leesanghyoek/Quiz-Clicker_IoT-Device/docs/images/erd.png

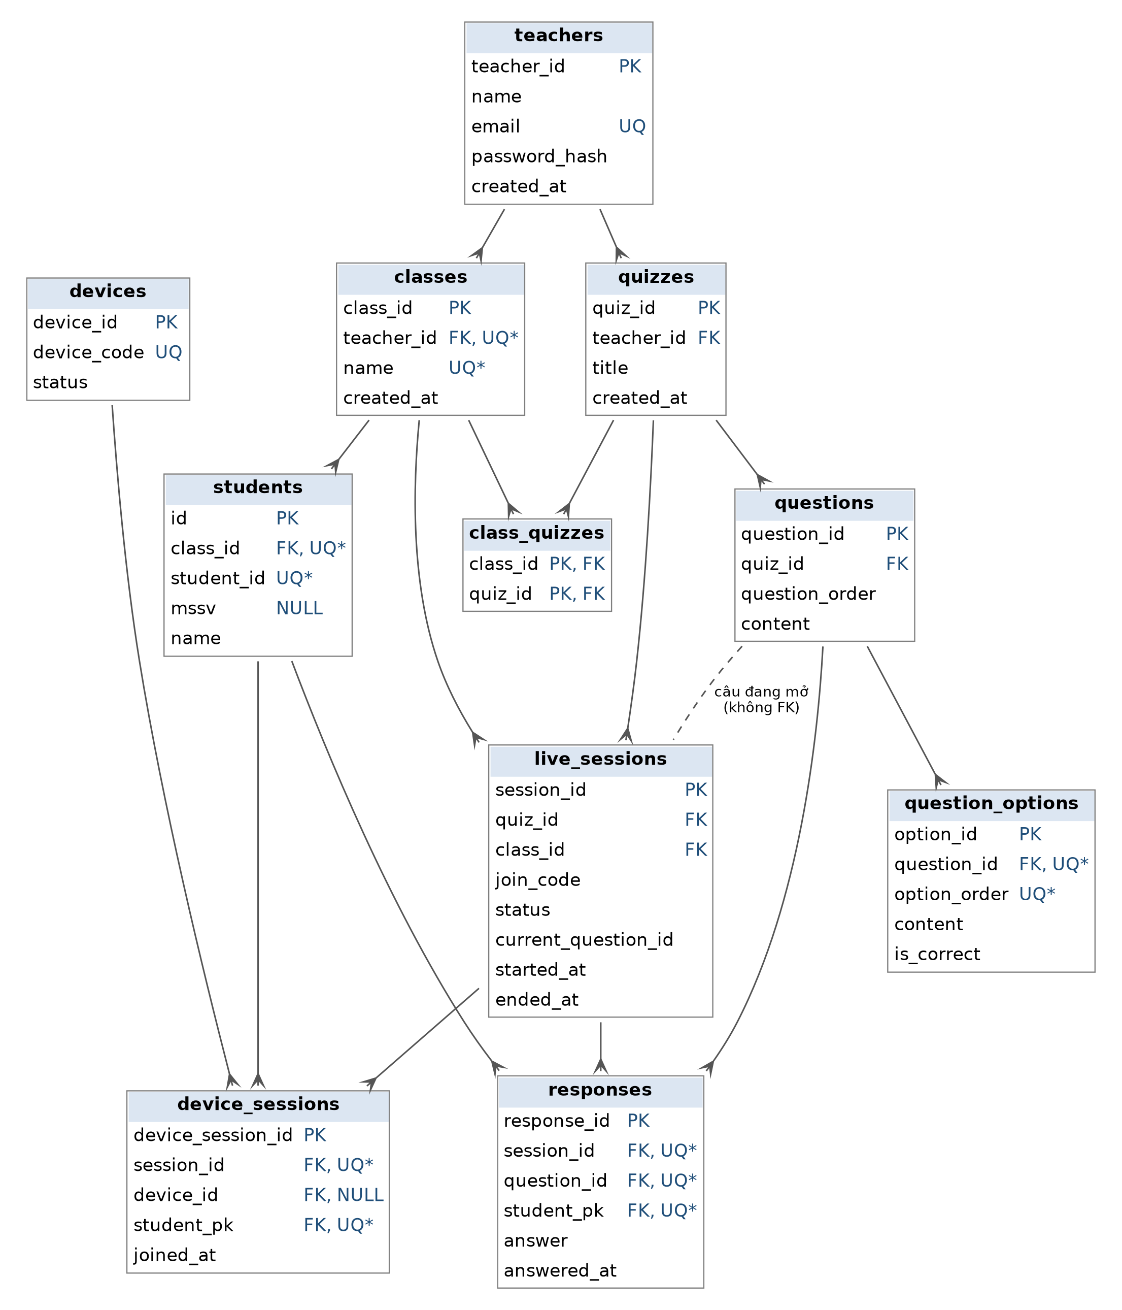
docs/images/erd.png
