leesanghyoek/Quiz-Clicker_IoT-Device/iot/docs/diagrams/01-kien-truc-tong-the.png

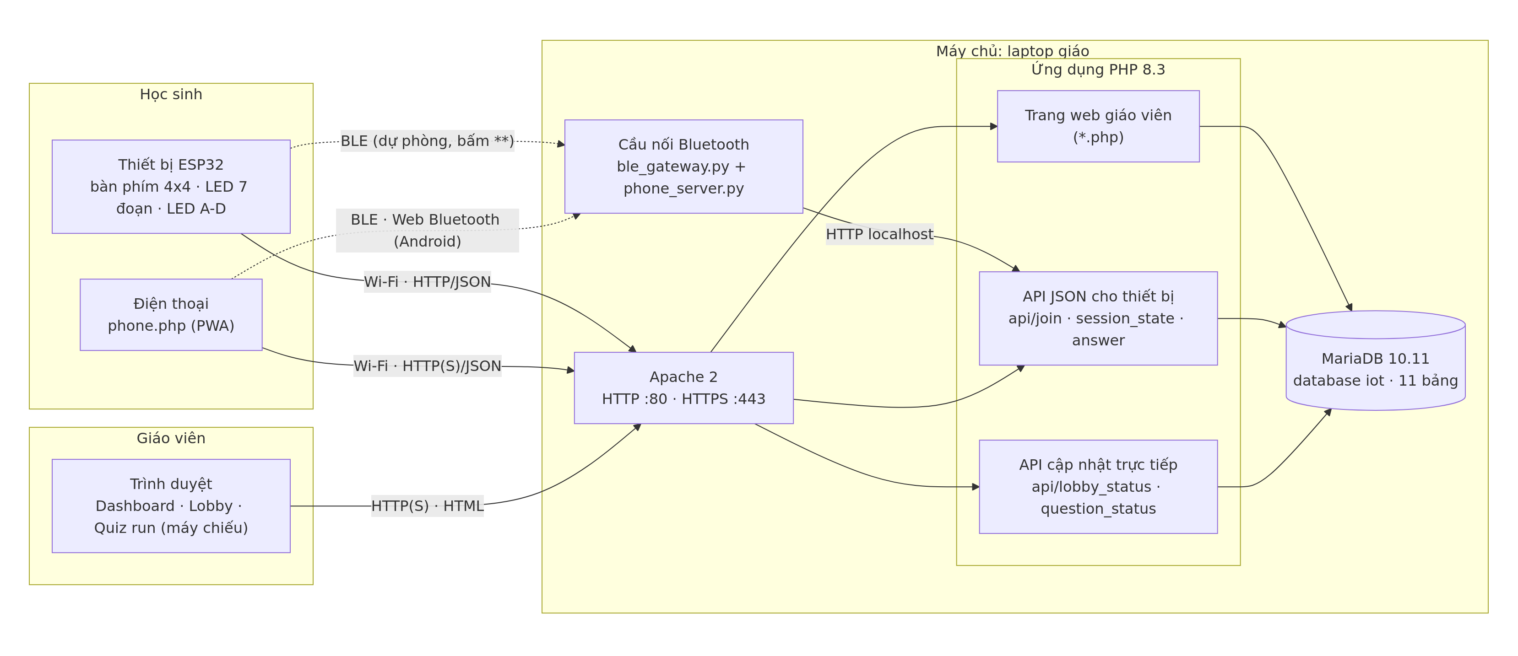
iot/docs/diagrams/01-kien-truc-tong-the.png
