leesanghyoek/Quiz-Clicker_IoT-Device/iot/docs/diagrams/02-trien-khai-mang.png

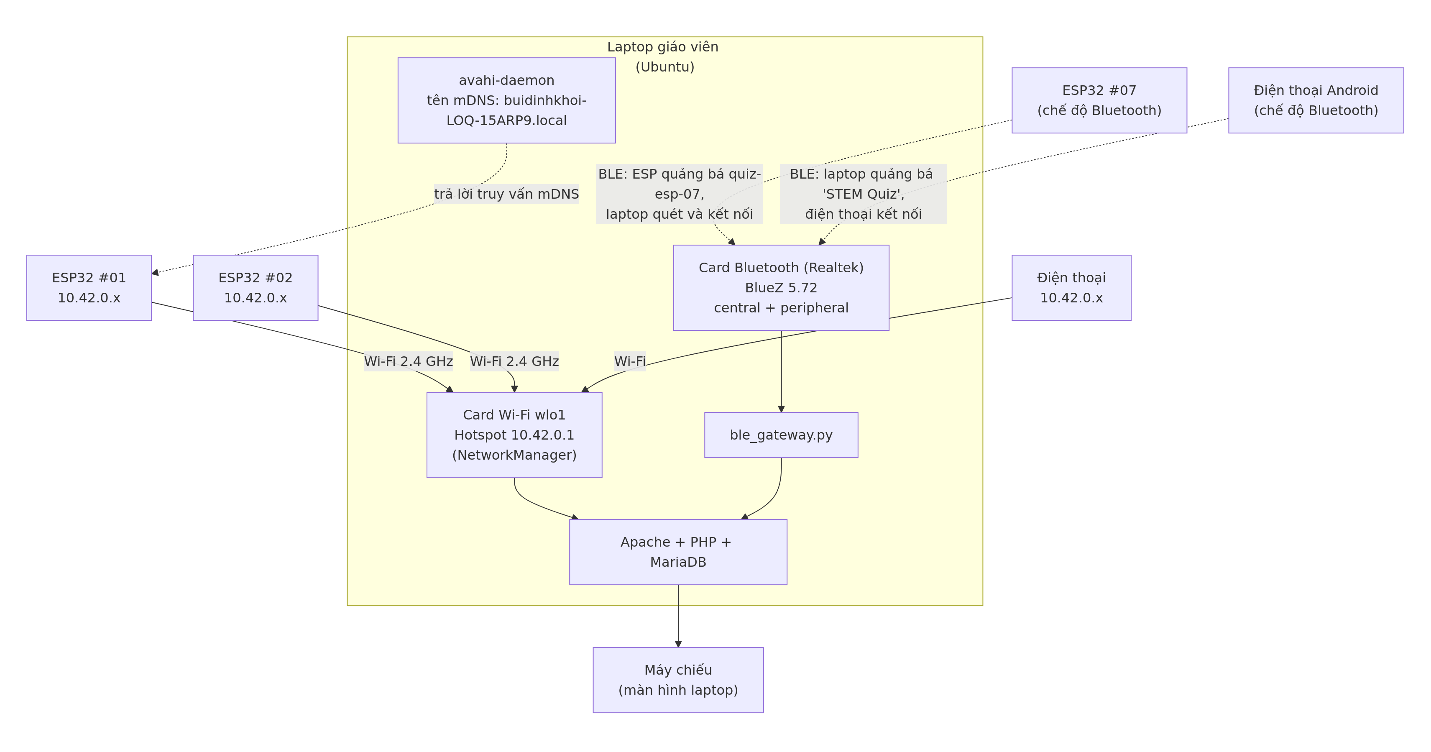
iot/docs/diagrams/02-trien-khai-mang.png
