leesanghyoek/Quiz-Clicker_IoT-Device/iot/docs/diagrams/03-phan-tang-phan-mem.png

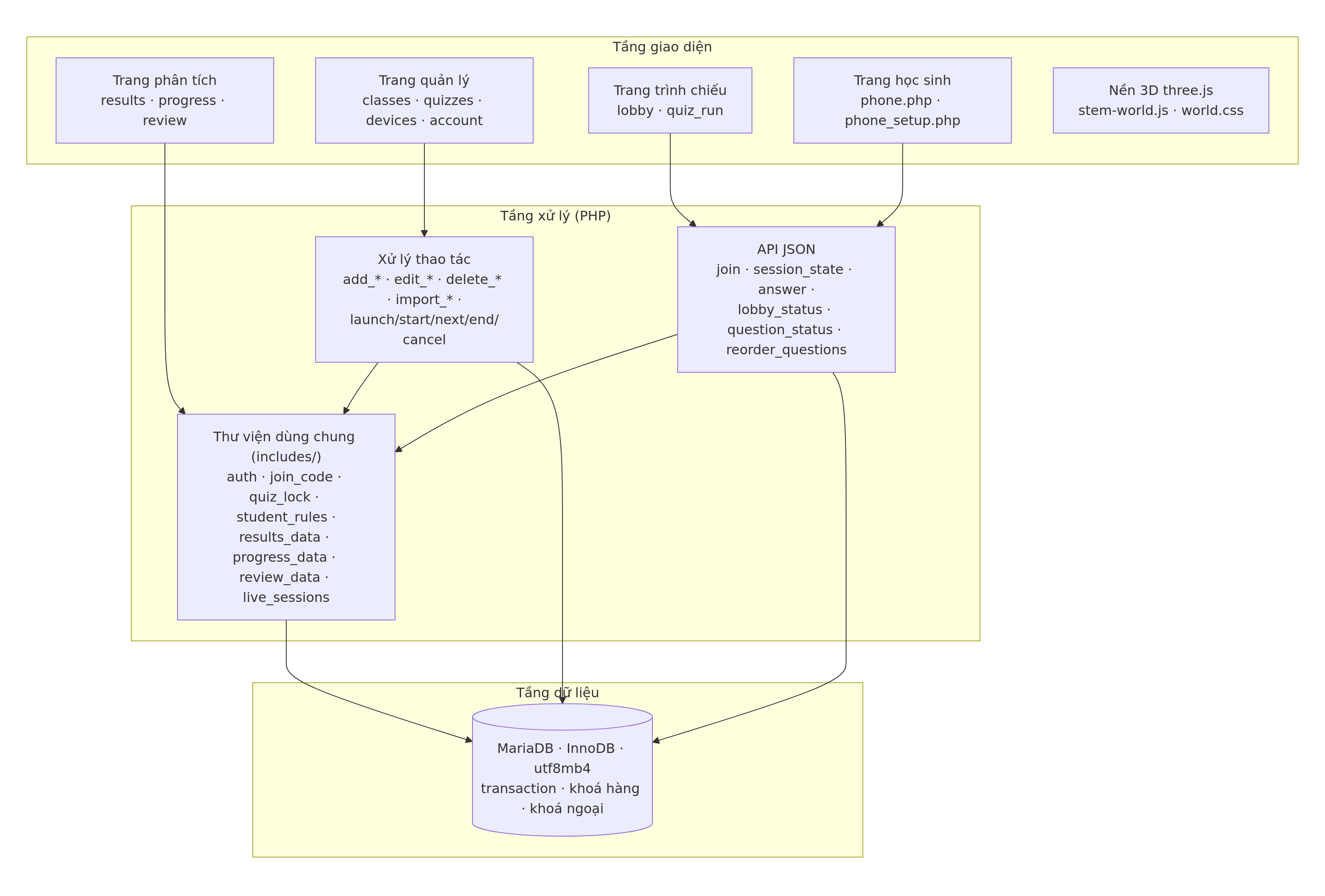
iot/docs/diagrams/03-phan-tang-phan-mem.png
