leesanghyoek/Quiz-Clicker_IoT-Device/iot/docs/diagrams/04-erd-co-so-du-lieu.png

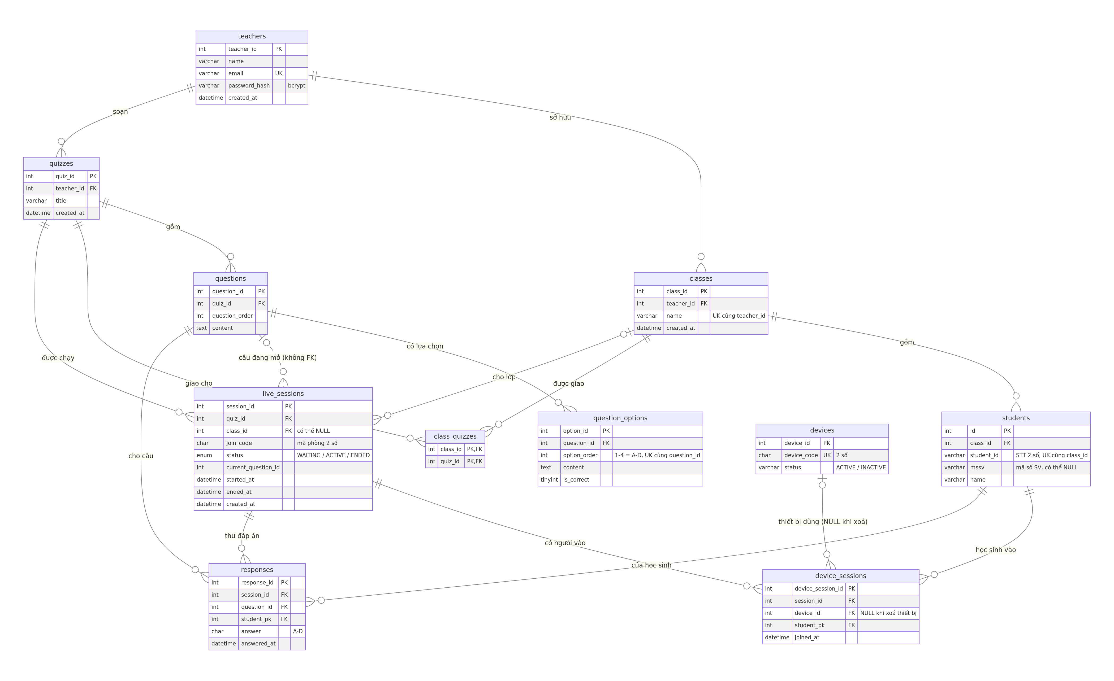
iot/docs/diagrams/04-erd-co-so-du-lieu.png
