leesanghyoek/Quiz-Clicker_IoT-Device/iot/docs/diagrams/05-tuan-tu-buoi-quiz.png

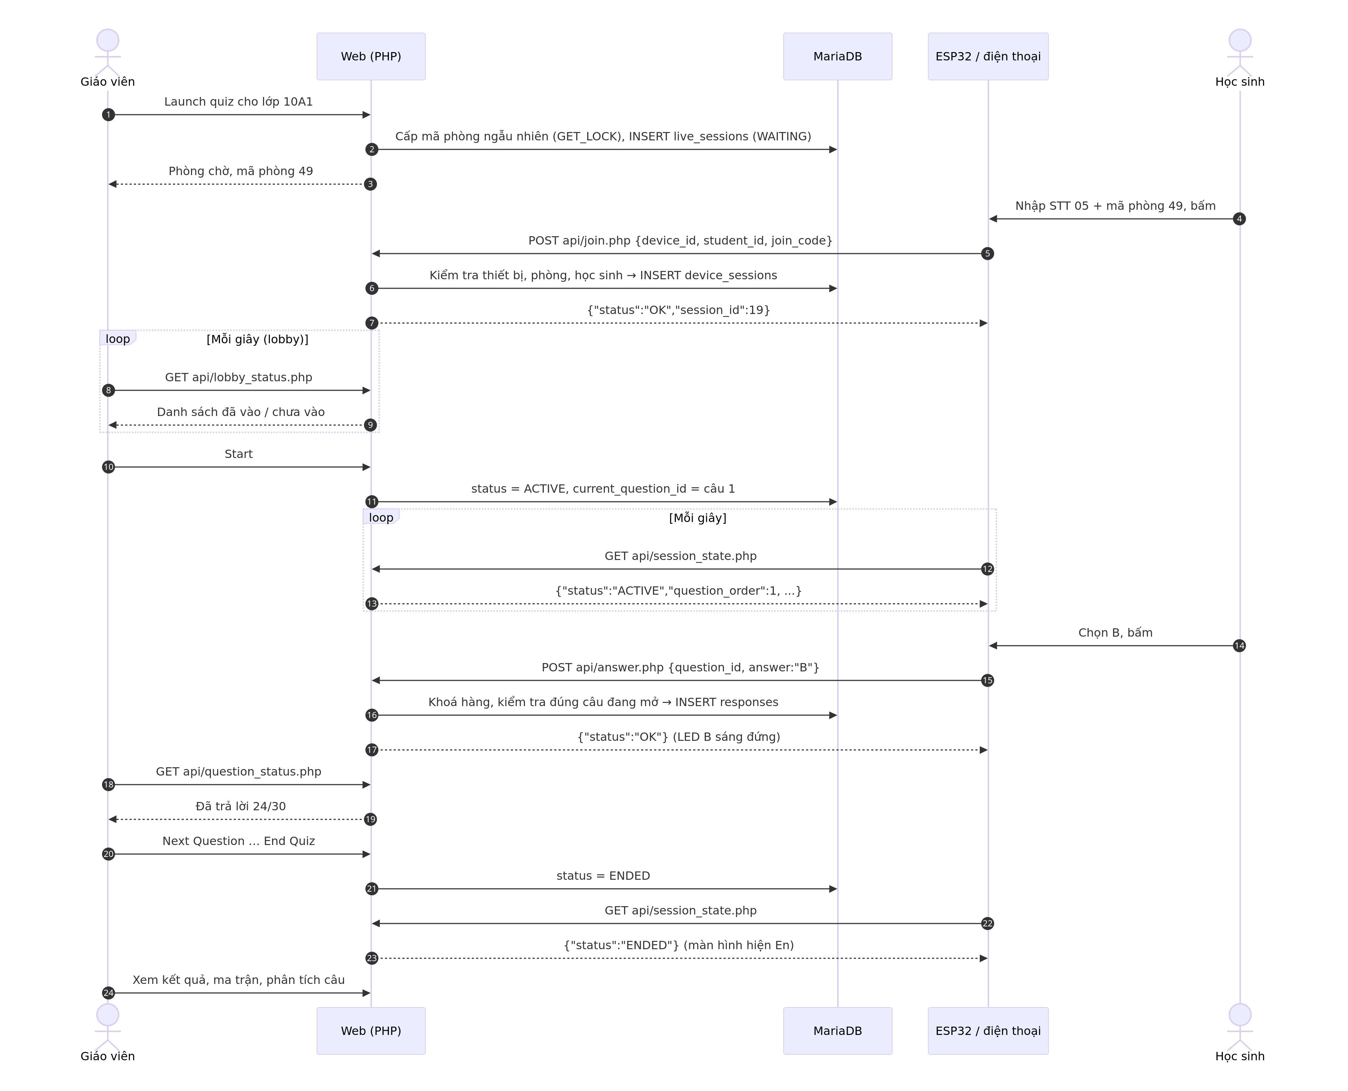
iot/docs/diagrams/05-tuan-tu-buoi-quiz.png
