leesanghyoek/Quiz-Clicker_IoT-Device/iot/docs/diagrams/06a-tuan-tu-ble-esp32.png

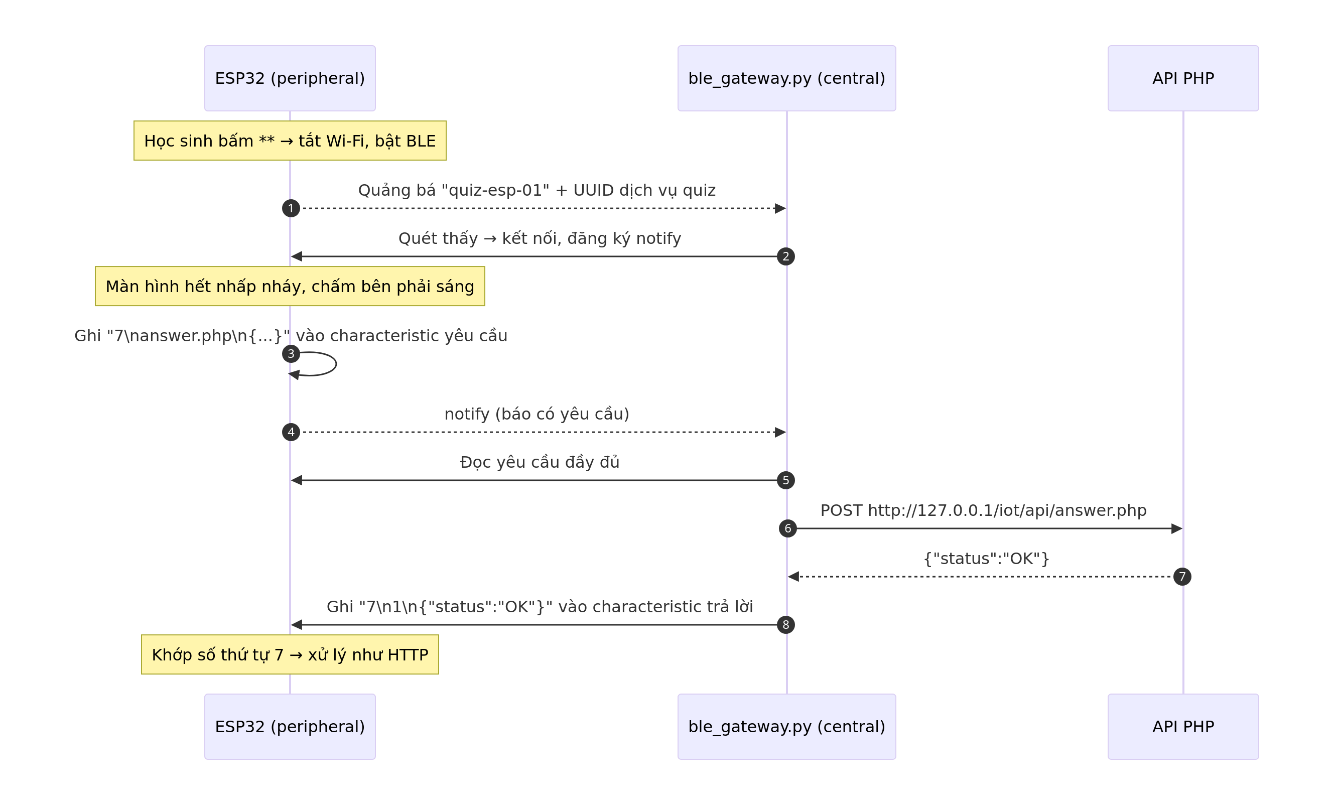
iot/docs/diagrams/06a-tuan-tu-ble-esp32.png
