leesanghyoek/Quiz-Clicker_IoT-Device/iot/docs/diagrams/06b-tuan-tu-ble-dien-thoai.png

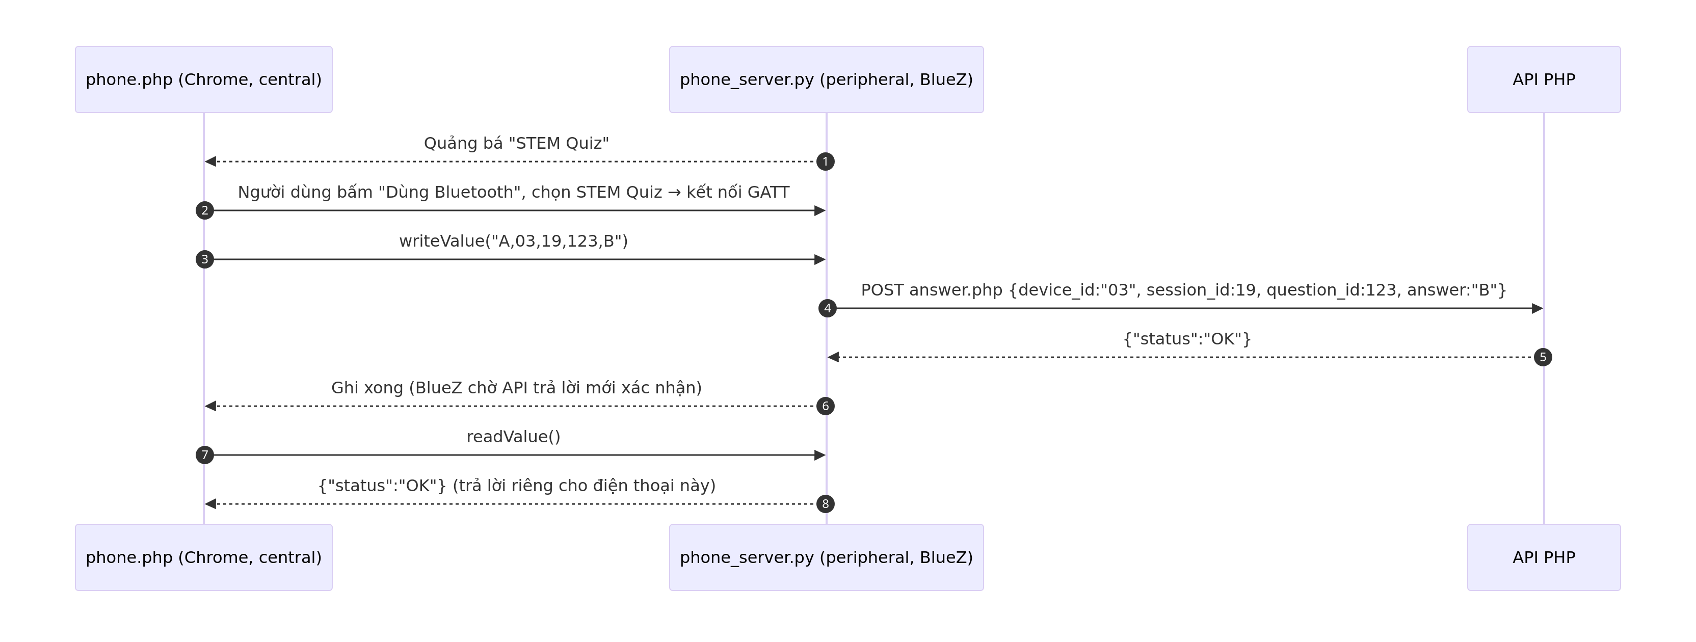
iot/docs/diagrams/06b-tuan-tu-ble-dien-thoai.png
