leesanghyoek/Quiz-Clicker_IoT-Device/iot/docs/diagrams/07-trang-thai-phien.png

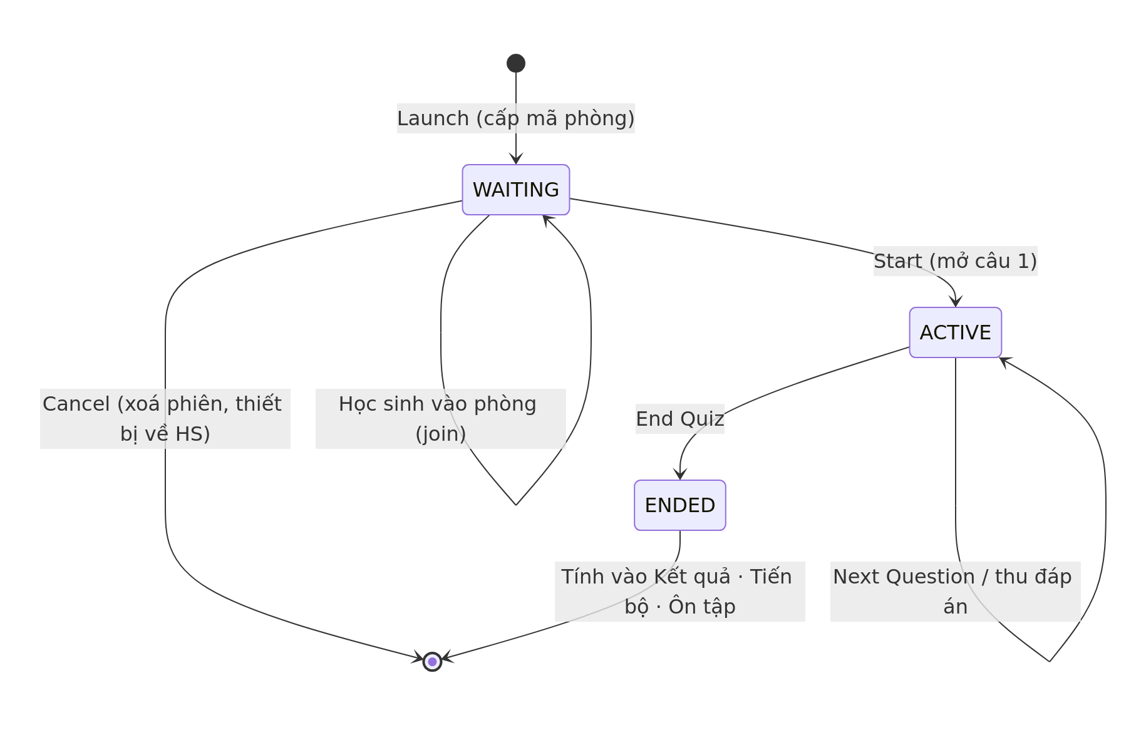
iot/docs/diagrams/07-trang-thai-phien.png
