leesanghyoek/Quiz-Clicker_IoT-Device/iot/docs/diagrams/08a-trang-thai-esp32.png

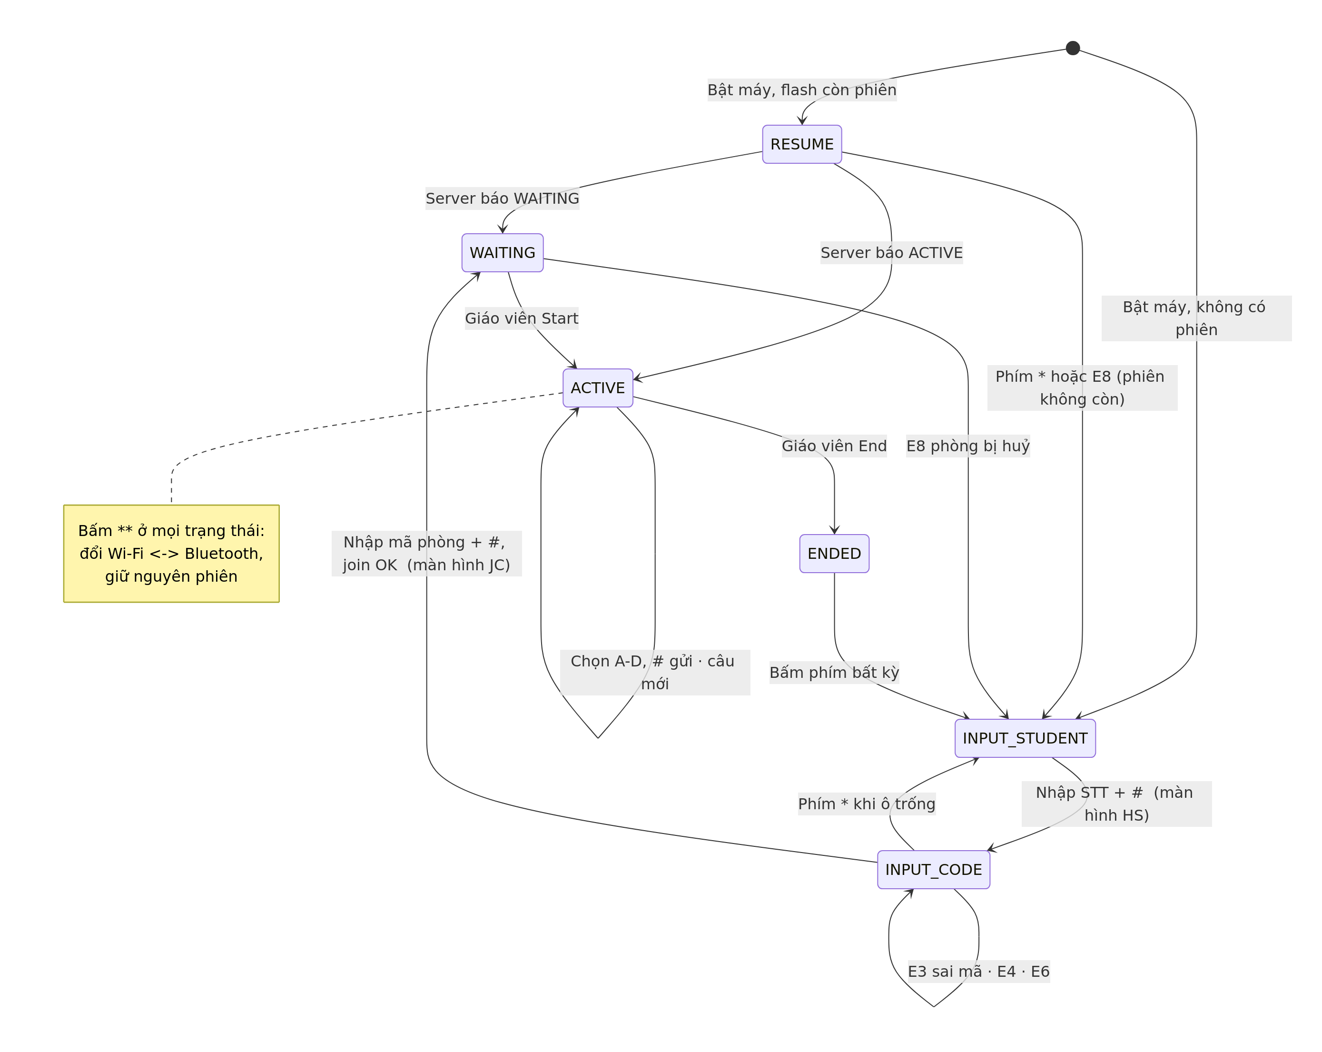
iot/docs/diagrams/08a-trang-thai-esp32.png
