leesanghyoek/Quiz-Clicker_IoT-Device/iot/docs/diagrams/08b-kien-truc-firmware.png

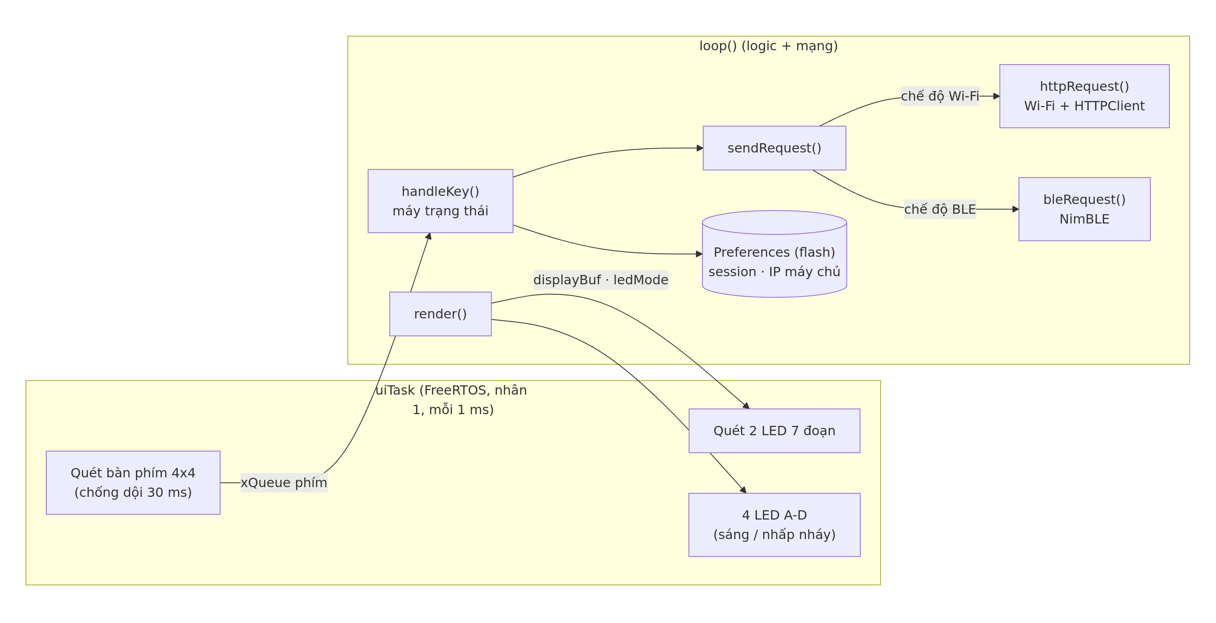
iot/docs/diagrams/08b-kien-truc-firmware.png
