leesanghyoek/Quiz-Clicker_IoT-Device/iot/docs/diagrams/09-tim-may-chu.png

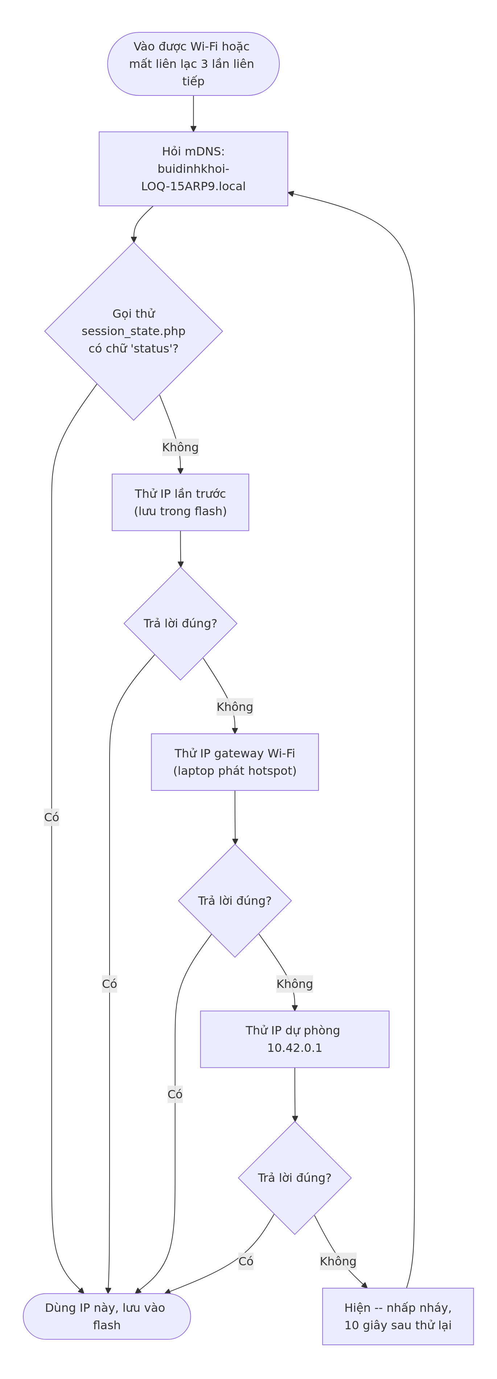
iot/docs/diagrams/09-tim-may-chu.png
