leesanghyoek/Quiz-Clicker_IoT-Device/(commit log)

2026-10-14 Báo cáo dự án: kiến trúc, cấu trúc dữ liệu, luồng thực thi kèm sơ đồ
2026-10-14 Thêm bảng danh sách thành viên nhóm
2026-10-14 Update device description from ESP32 to IoT ESP32
2026-10-15 Thêm ảnh thiết bị trả lời
2026-10-15 Thu nhỏ ảnh thiết bị trong README
2026-10-15 Đổi tên firmware thành code.ino, thêm bản code.txt
2026-10-15 Thêm mã nguồn web và ảnh giao diện
2026-10-15 Thêm mã nguồn web
2026-10-15 Thêm sơ đồ nguyên lý (schematic) thiết bị ESP32
2026-10-15 README: sửa mô tả nguồn thiết bị theo schematic (pin + công tắc)
